ptrindade96/SCDTR-Proj/Prototype_Pictures/49834054_2505776932828480_8325022233248399360_n.jpg

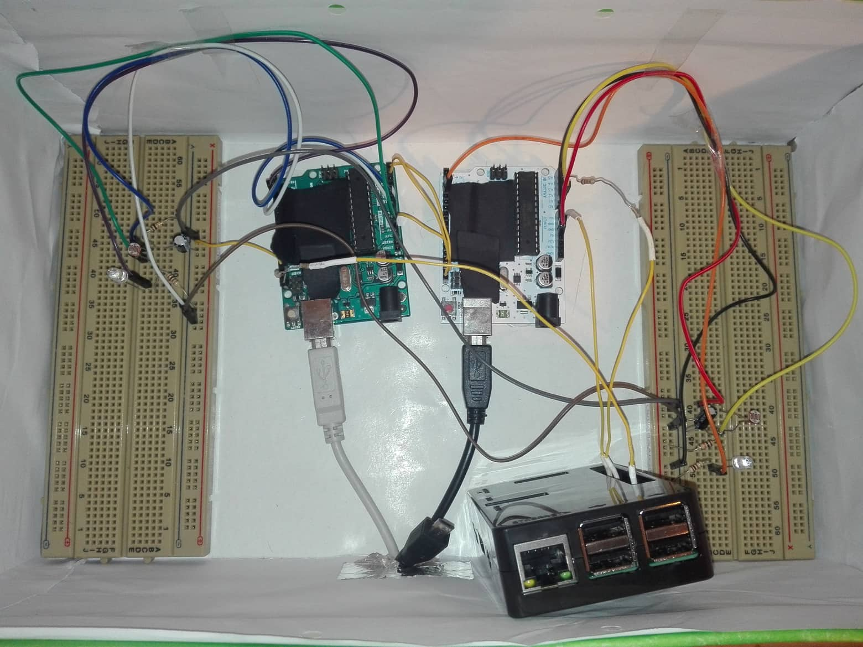
Prototype_Pictures/49834054_2505776932828480_8325022233248399360_n.jpg
