ptrindade96/SCDTR-Proj/Prototype_Pictures/49896126_612225292543001_4518552856659230720_n.jpg

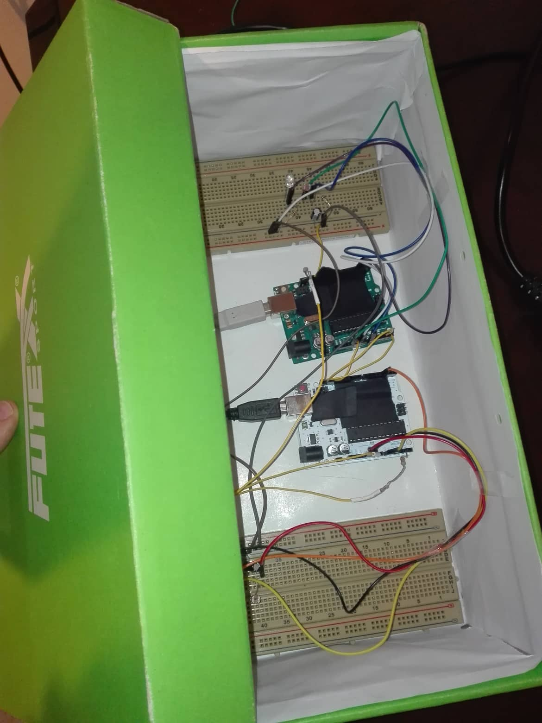
Prototype_Pictures/49896126_612225292543001_4518552856659230720_n.jpg
