ptrindade96/SCDTR-Proj/Prototype_Pictures/50073231_2322950967934117_8994590128408100864_n.jpg

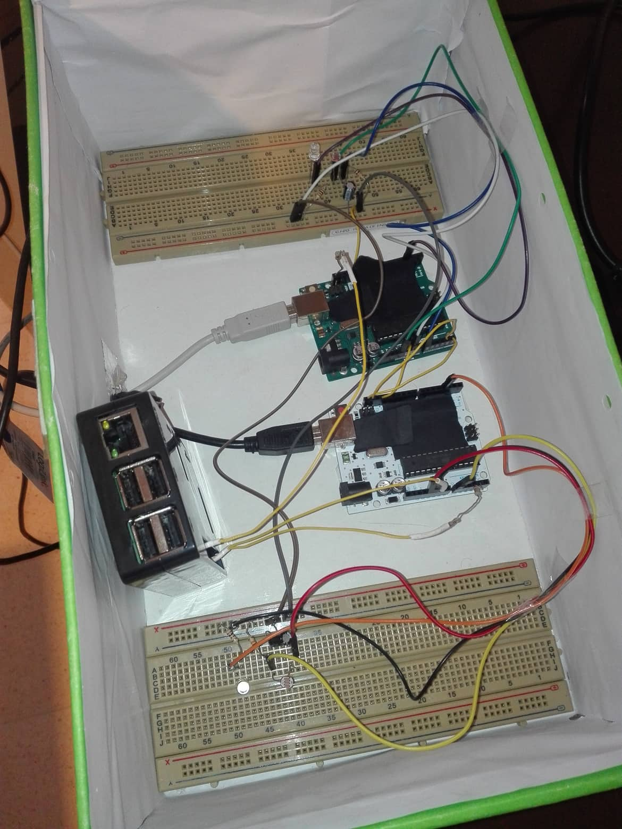
Prototype_Pictures/50073231_2322950967934117_8994590128408100864_n.jpg
